ywkuo/Helth-monitoring-and-management-system/auto-thermometer/components_1.jpg

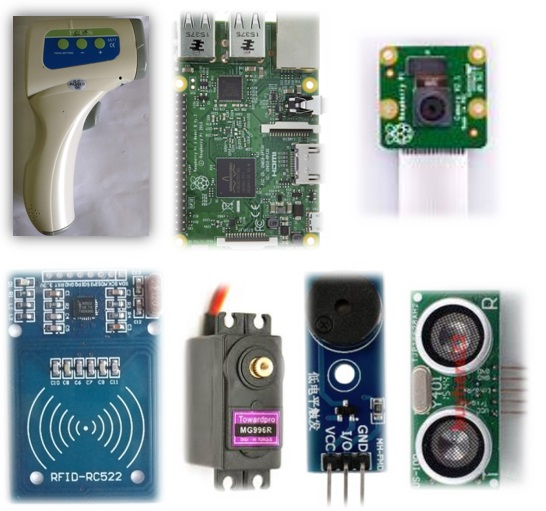
auto-thermometer/components_1.jpg
