ywkuo/Helth-monitoring-and-management-system/screener/components_2.jpg

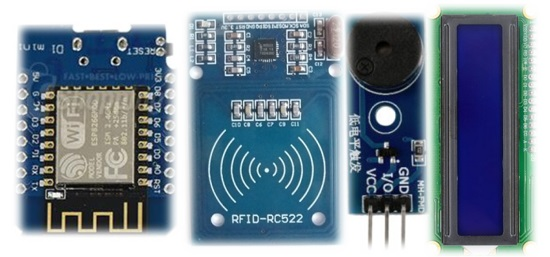
screener/components_2.jpg
