ywkuo/Helth-monitoring-and-management-system/photo/圖書館.jpg

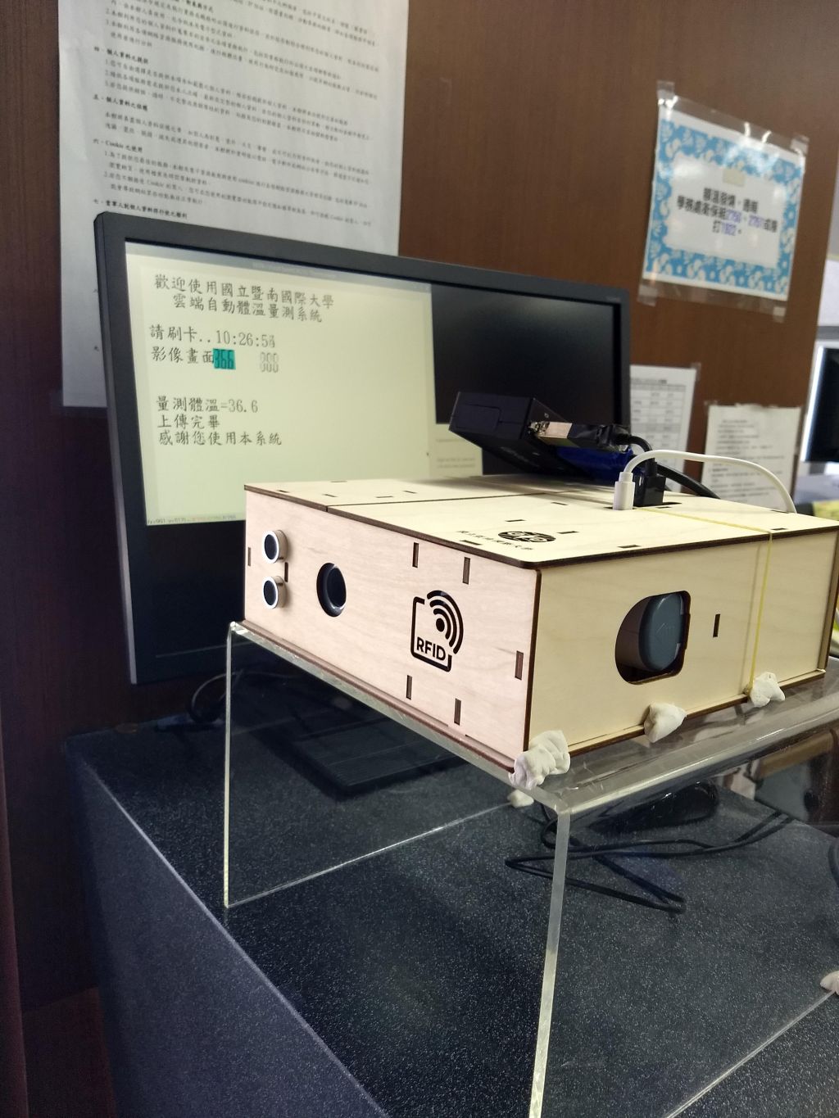
photo/圖書館.jpg
