ywkuo/Helth-monitoring-and-management-system/photo/女大宿舍.jpg

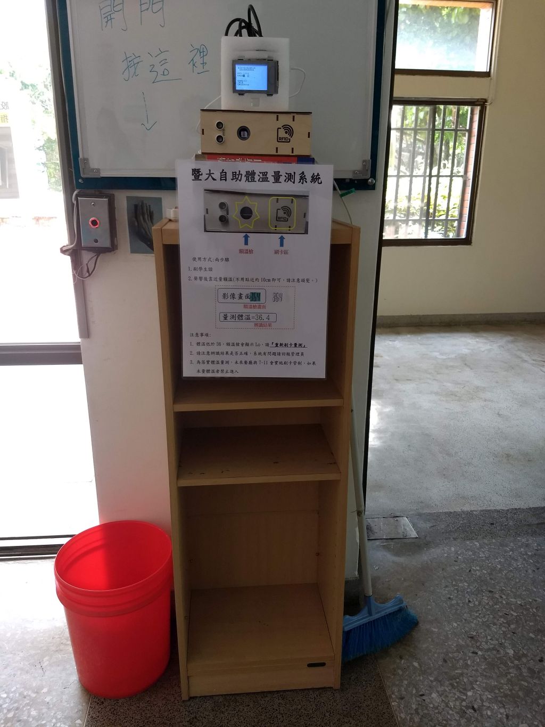
photo/女大宿舍.jpg
