ywkuo/Helth-monitoring-and-management-system/photo/女研宿舍.jpg

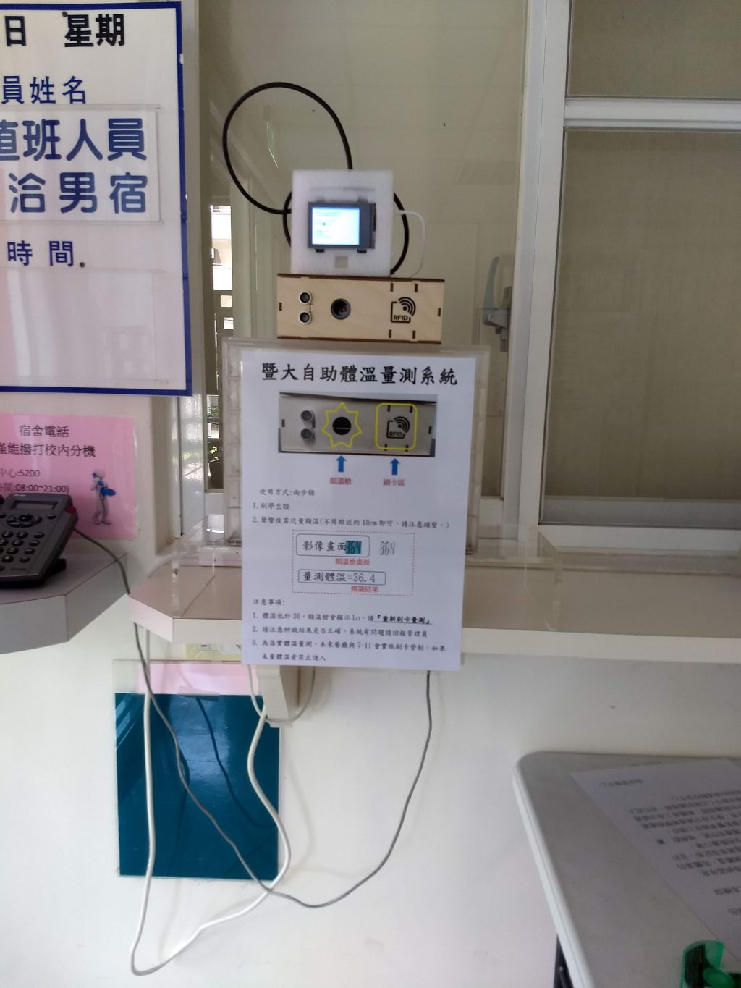
photo/女研宿舍.jpg
