ywkuo/Helth-monitoring-and-management-system/photo/男大宿舍.jpg

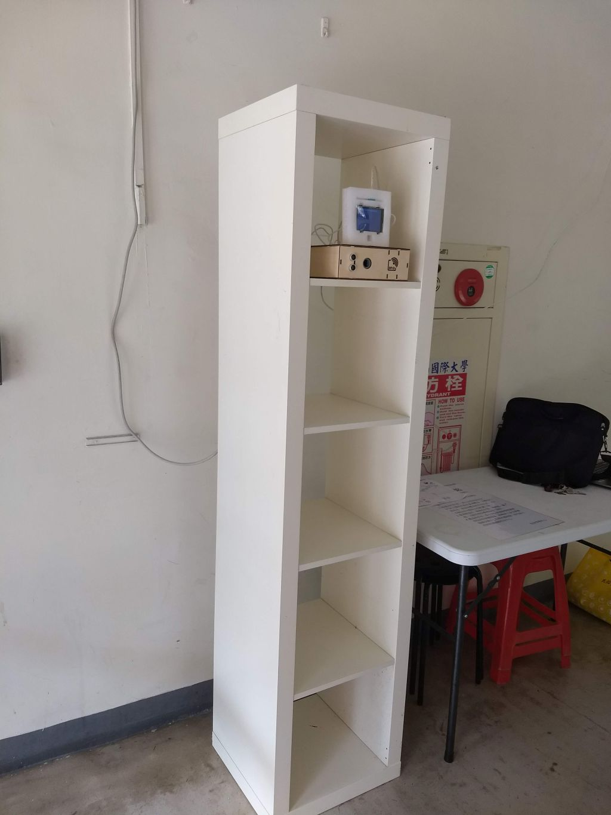
photo/男大宿舍.jpg
