ywkuo/Helth-monitoring-and-management-system/photo/男研宿舍.jpg

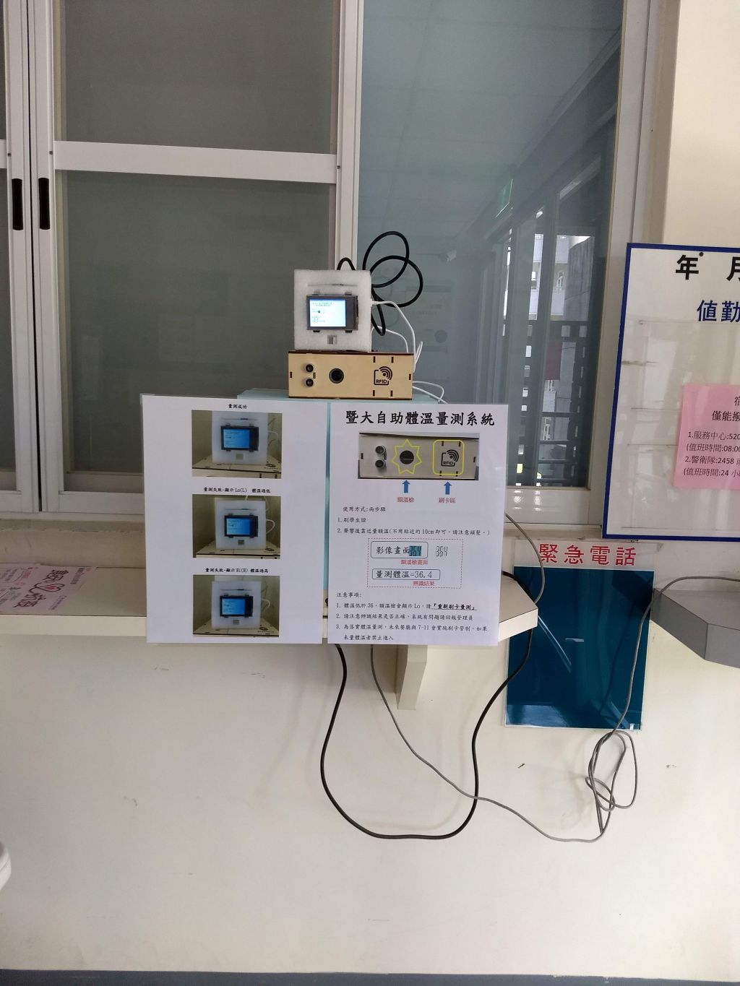
photo/男研宿舍.jpg
