ywkuo/Helth-monitoring-and-management-system/photo/行政大樓.jpg

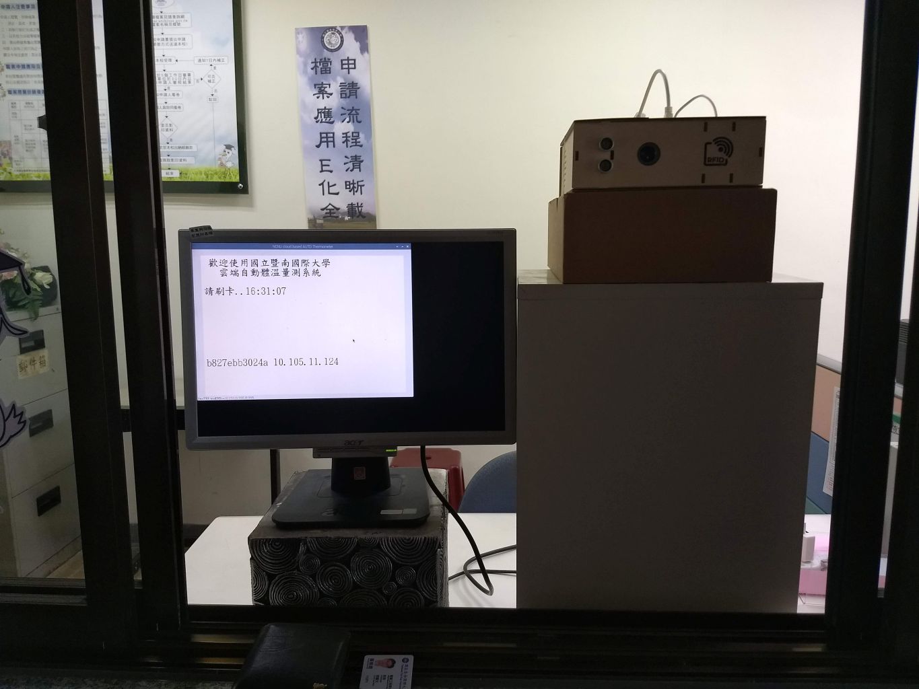
photo/行政大樓.jpg
