ywkuo/Helth-monitoring-and-management-system/photo/電機系.jpg

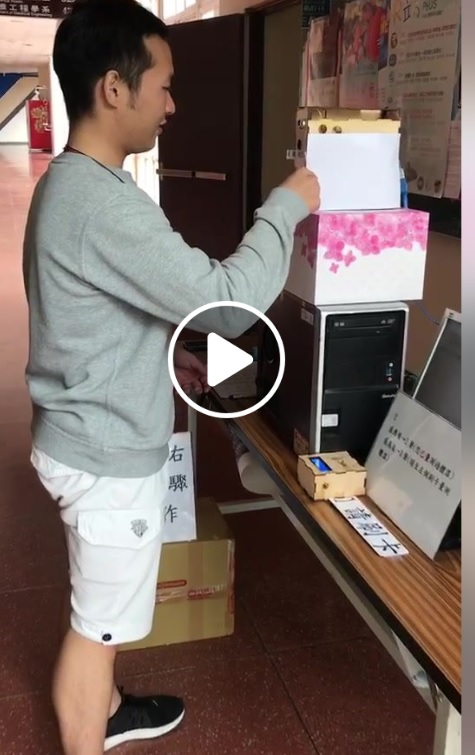
photo/電機系.jpg
