ywkuo/Helth-monitoring-and-management-system/photo/餐廳.jpg

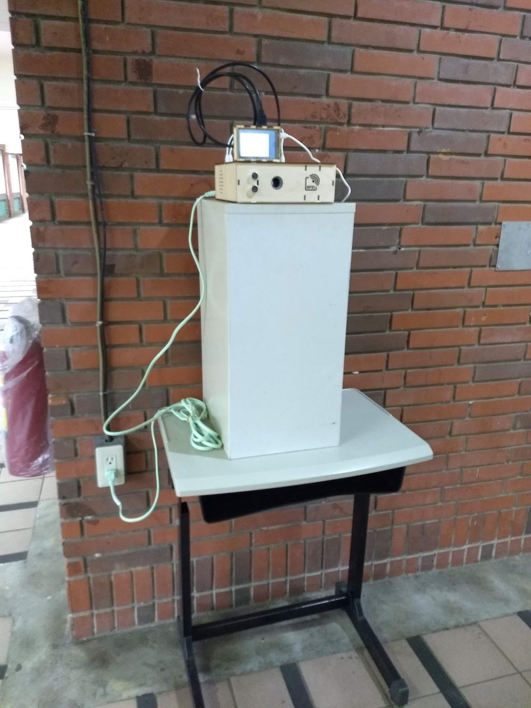
photo/餐廳.jpg
