ywkuo/Helth-monitoring-and-management-system/photo/體健中心.jpg

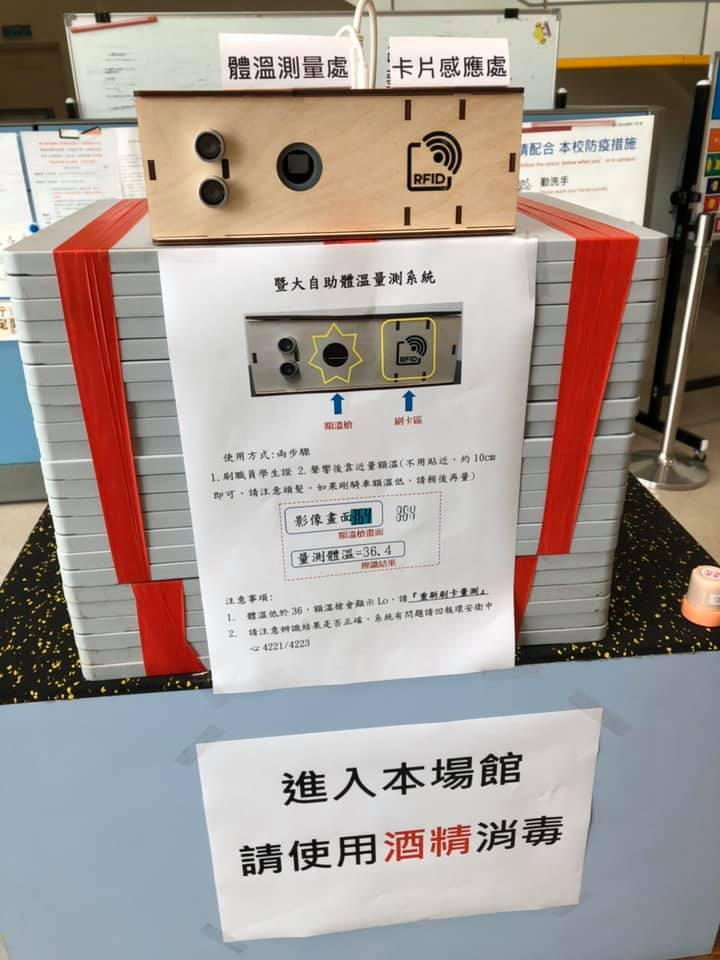
photo/體健中心.jpg
