ywkuo/Helth-monitoring-and-management-system/screener/screener.pdf

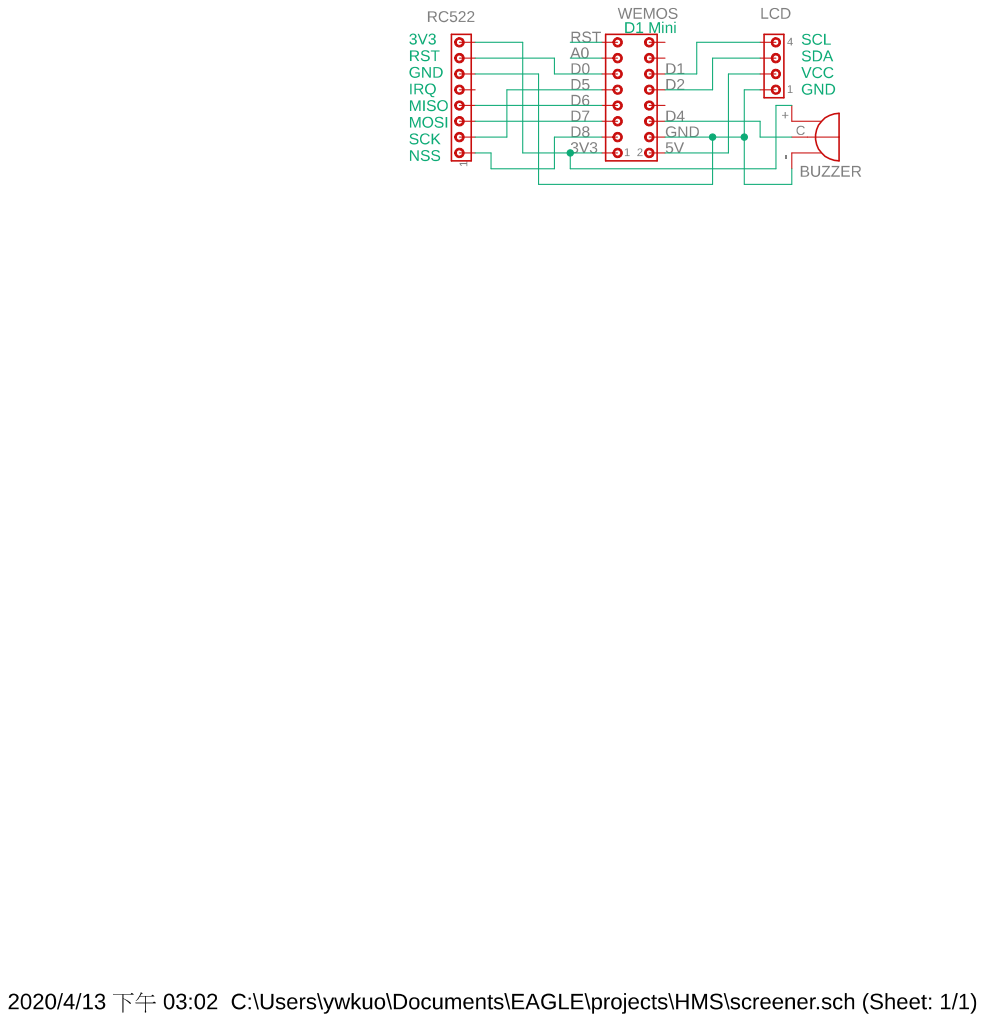
[picture p27: page 1]
