ywkuo/Helth-monitoring-and-management-system/auto-thermometer/auto.pdf

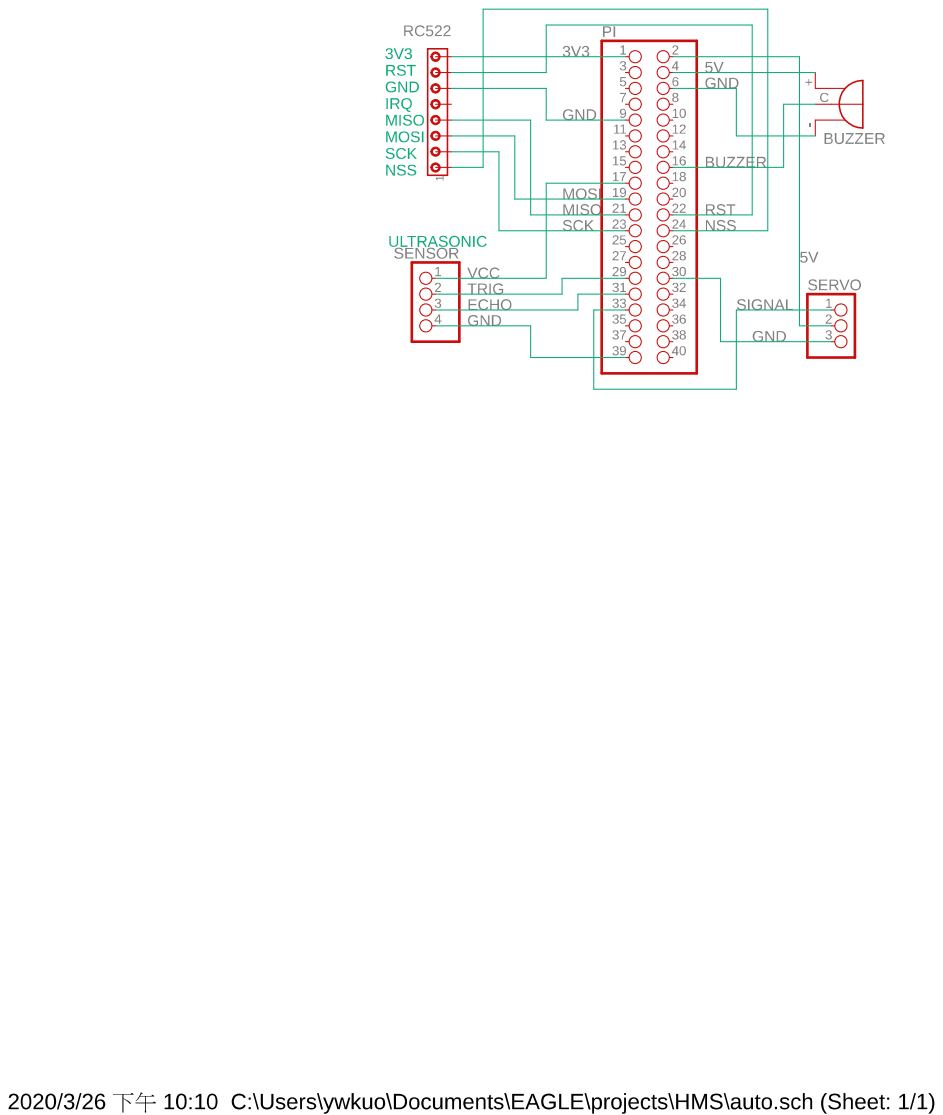
[picture p28: page 1]
